jevankovich/spiflasher/pcba/spiflasher.jpg

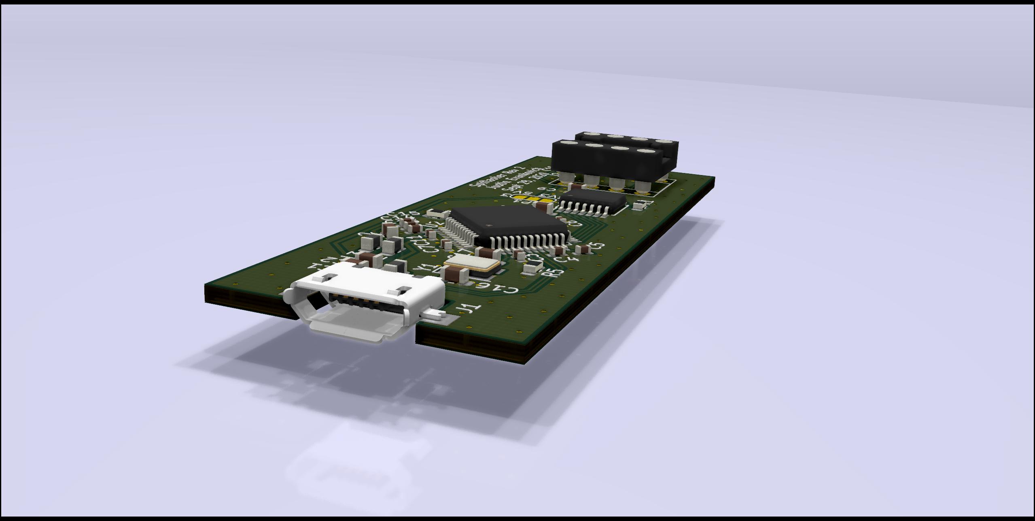
pcba/spiflasher.jpg
