jevankovich/spiflasher/pcba/USB3070-30-A.stp

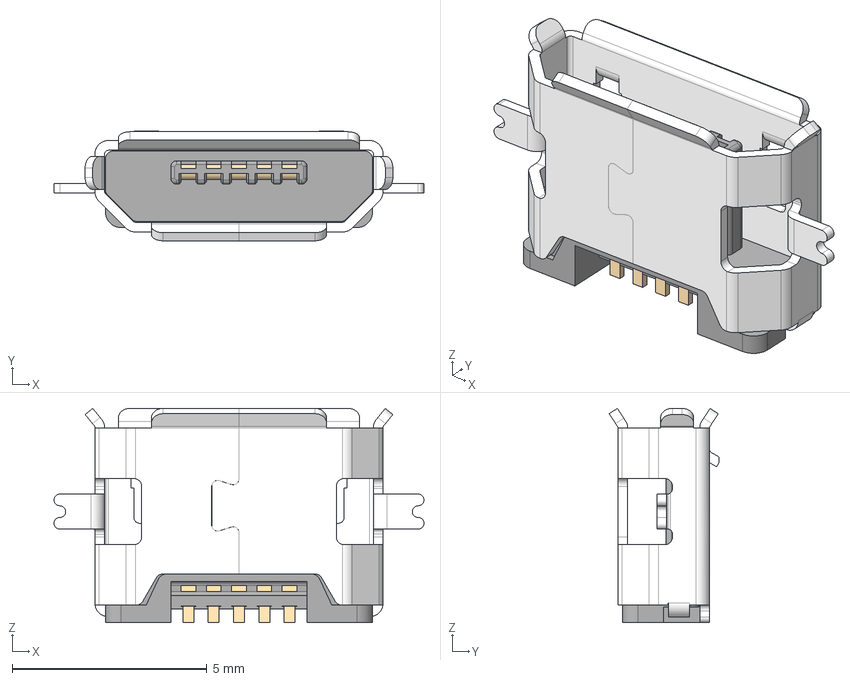
[picture p2: CAD file, 2020-09-30]
pcba/USB3070-30-A.stp
9.50 x 2.81 x 5.50 mm
Ô²½Ç1
ÇÐ³ý-ÀÉì6
Boss-Extrude1 x 5
