jevankovich/spiflasher/pcba/spiflasher.kicad_pcb

## KiCad design pcba/spiflasher.kicad_pcb (2020-09-30)

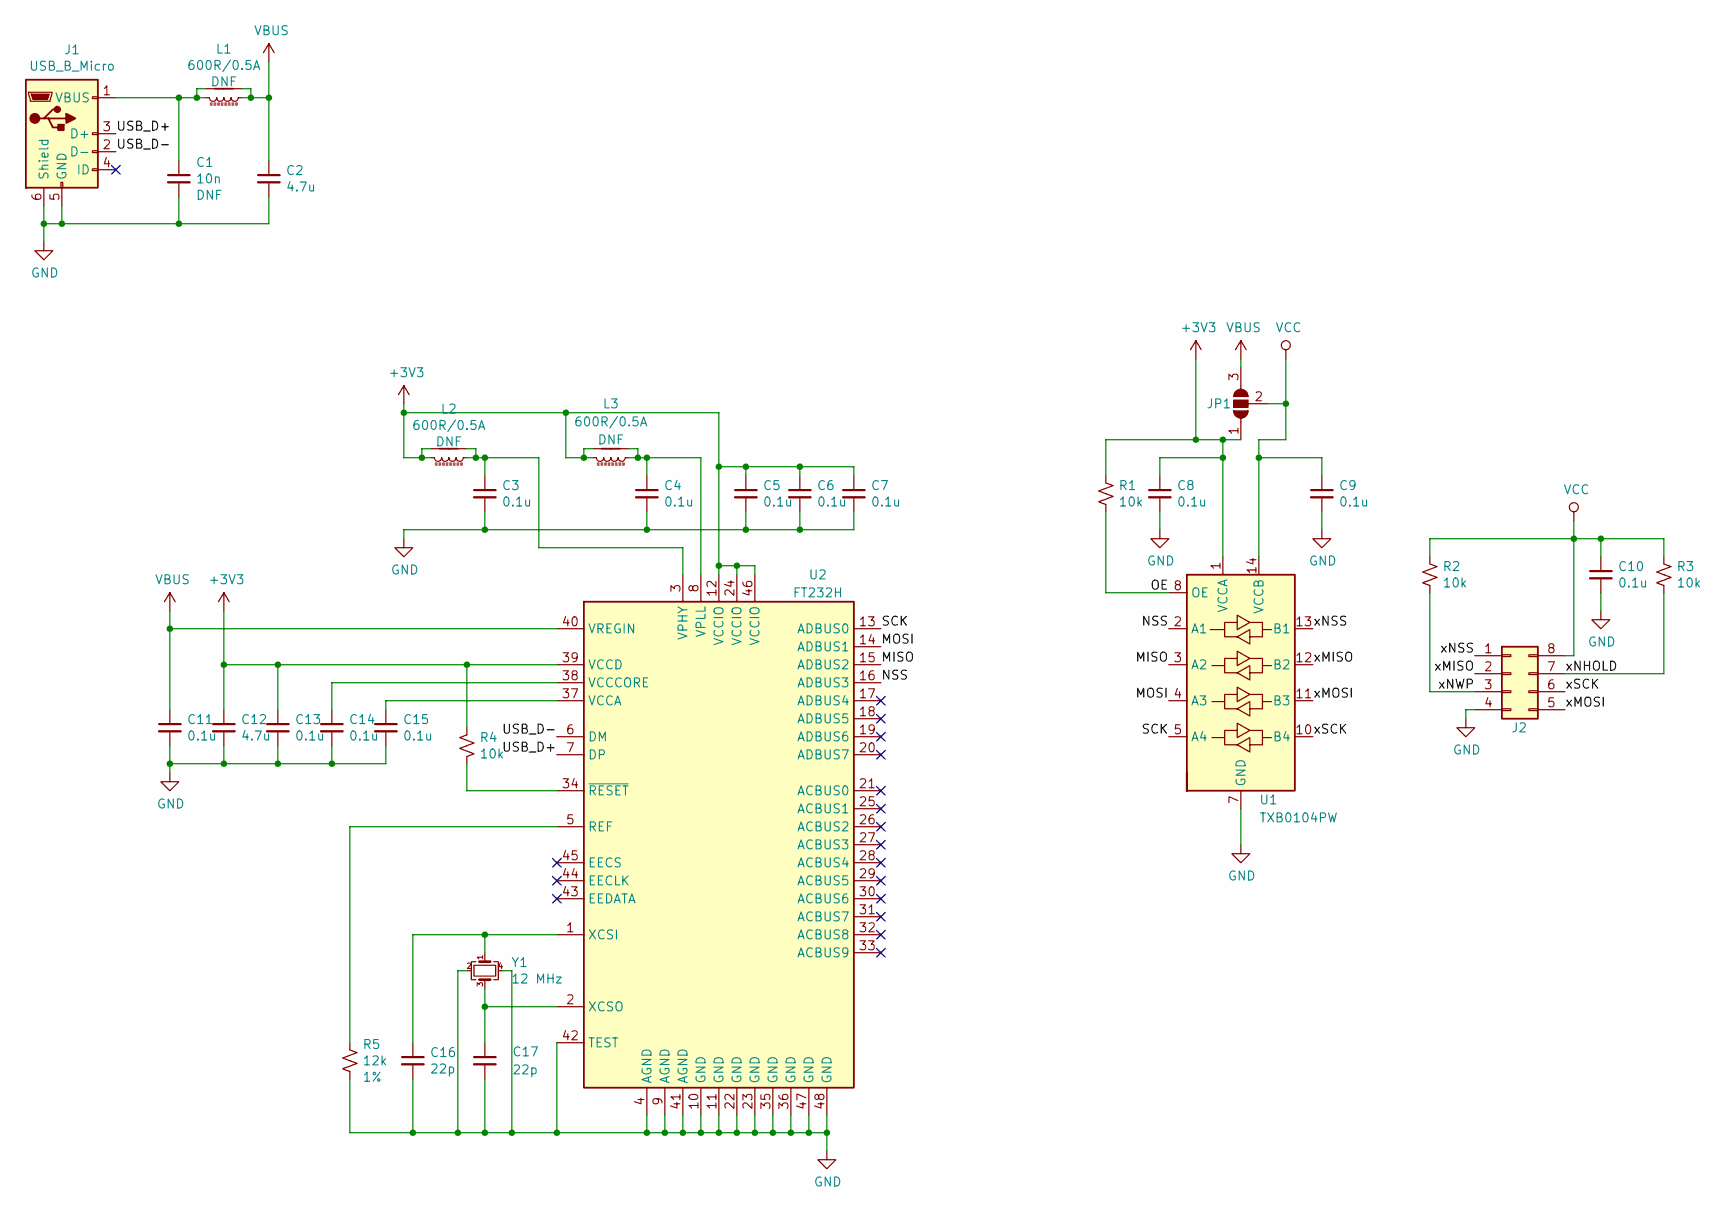
[picture p3: schematic spiflasher.sch]

Parts:
C1: 10n; C_0603_1608Metric; LCSC C57112
C2, C12: 4.7u; C_0603_1608Metric; LCSC C19666
C3, C4, C5, C6, C7, C11, C13, C14, C15: 0.1u; C_0402_1005Metric; LCSC C1525
C8, C9, C10: 0.1u; C_0603_1608Metric; LCSC C14663
C16, C17: 22p; C_0603_1608Metric; LCSC C1653
J1: USB_B_Micro; USB_Micro-B_GCT_USB3070; Digikey 2073-USB3070-30-ACT-ND
J2: Conn_02x04_Counter_Clockwise; DIP-8_W7.62mm_Socket; Digikey 1212-1003-ND
JP1: SolderJumper_3_Open; SolderJumper-3_P1.3mm_Open_RoundedPad1.0x1.5mm_NumberLabels
L1, L2, L3: 600R/0.5A; L_0603_1608Metric; LCSC C21189
NT1, NT2, NT3: Net-Tie_2; NetTie-2_SMD_Pad0.5mm
R1, R2, R3, R4: 10k; R_0603_1608Metric; LCSC C25804
R5: 12k; R_0603_1608Metric; Tolerance 1%; LCSC C22790
U1: TXB0104PW; TSSOP-14_4.4x5mm_P0.65mm; LCSC C60708
U2: FT232H; LQFP-48_7x7mm_P0.5mm; LCSC C51997
Y1: 12 MHz; Crystal_SMD_3225-4Pin_3.2x2.5mm; LCSC C9002

Connections:
+3V3: C5.1, C6.1, C7.1, C8.1, C12.1, C13.1, JP1.1 (A), L2.2, L3.2, NT2.1, NT3.1, R1.1, R4.1, U1.1 (VCCA), U2.12 (VCCIO), U2.24 (VCCIO), U2.39 (VCCD), U2.46 (VCCIO)
/MISO: U1.3 (A2), U2.15 (ADBUS2)
/MOSI: U1.4 (A3), U2.14 (ADBUS1)
/NSS: U1.2 (A1), U2.16 (ADBUS3)
/OE: R1.2, U1.8 (OE)
/SCK: U1.5 (A4), U2.13 (ADBUS0)
/USB_D+: J1.3 (D+), U2.7 (DP)
/USB_D-: J1.2 (D-), U2.6 (DM)
/xMISO: J2.2, U1.12 (B2)
/xMOSI: J2.5, U1.11 (B3)
/xNHOLD: J2.7, R3.2
/xNSS: J2.1, U1.13 (B1)
/xNWP: J2.3, R2.2
/xSCK: J2.6, U1.10 (B4)
GND: C1.2, C2.2, C3.2, C4.2, C5.2, C6.2, C7.2, C8.2, C9.2, C10.2, C11.2, C12.2, C13.2, C14.2, C15.2, C16.2, C17.2, J1.5 (GND), J1.6 (Shield), J2.4, R5.2, U1.7 (GND), U2.4 (AGND), U2.9 (AGND), U2.10 (GND), U2.11 (GND), U2.22 (GND), U2.23 (GND), U2.35 (GND), U2.36 (GND), U2.41 (AGND), U2.42 (TEST), U2.47 (GND), U2.48 (GND), Y1.2, Y1.4
unnamed: C1.1, J1.1 (VBUS), L1.2, NT1.1
unnamed: C3.1, L2.1, NT2.2, U2.3 (VPHY)
unnamed: C4.1, L3.1, NT3.2, U2.8 (VPLL)
unnamed: C14.1, U2.38 (VCCCORE)
unnamed: C15.1, U2.37 (VCCA)
unnamed: C16.1, U2.1 (XCSI), Y1.1
unnamed: C17.1, U2.2 (XCSO), Y1.3
unnamed: R4.2, U2.34 (~RESET)
unnamed: R5.1, U2.5 (REF)
VBUS: C2.1, C11.1, JP1.3 (B), L1.1, NT1.2, U2.40 (VREGIN)
VCC: C9.1, C10.1, J2.8, JP1.2 (C), R2.1, R3.1, U1.14 (VCCB)

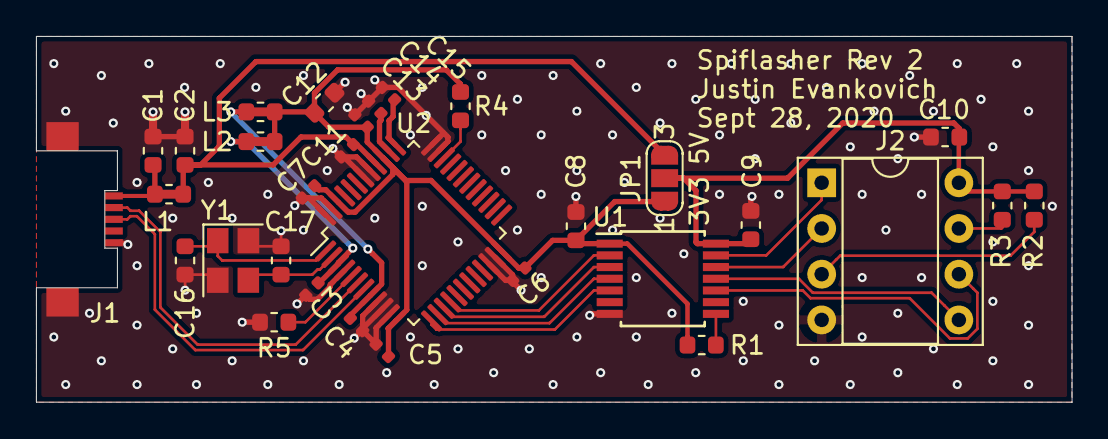
[picture p4: board spiflasher.kicad_pcb from above]

Board: 2 copper layers, 57.5 x 20.3 mm, 34 parts (0 on the bottom side), 26 nets.
