jevankovich/spiflasher/(commit log)

2020-08-30 Added bom generation
2020-09-02 Changed crystal Digikey P/N to a non-marketplace one
    [spiflasher.sch]
2020-09-09 Removed unnecessary components.
    [spiflasher.kicad_pcb, spiflasher.sch]
2020-09-28 Low profile USB port. Final Rev 2
    [spiflasher.kicad_pcb, spiflasher.sch]
2020-09-30 Added 3D model for USB port
    [USB3070-30-A.stp, spiflasher.kicad_pcb]
