jevankovich/spiflasher/(notices)

Notices in the files:
pcba/USB3070-30-A.stp:
FILE_NAME( 'p:/temp/worker_507/temp/exporttempdir_408_206_HXKh3/format_0/USB3070-30-A.stp', '2020-09-30T22:46:52', ( 'License CC BY-ND 4.0' ), ( 'CADENAS' ), ' ', 'PARTsolutions', ' ' );
